kleinkuang/Imperial/Lacewing/PCB/LacewingPXE_v3p1/BOM.xlsx

Designator | Comment | Description | Manufacturer | Part No | Farnell Order Code | Mouser Order Code | Quantity
AD1 | AD8237ARMZ | Instrument Amplifier | ANALOG DEVICES | AD8237ARMZ | 2213571 |  | 1 | 10
BQ1 | BQ27750DRZT | Fuel Gauge and Protection | TEXAS INSTRUMENTS | BQ27750DRZT | 2773561 |  | 1 | 10
BQ2 | BQ25606RGET | Battery Charger | TEXAS INSTRUMENTS | BQ25606RGET | 3008740 |  | 1 | 10
C1 | 2.2uF | CAP 0402 | MURATA | GRM155R60J225ME15D | 2362088 |  | 1 | 10
C2, C3, C10, C11 | 0.1uF | CAP 0402 | AVX | 04026D104KAT2A | 1327657 |  | 4 | 40
C4, C7 | 10uF | CAP 0805 | AVX | 0805ZC106KAT2A | 2094042 |  | 2 | 20
C5 | 4.7µF | CAP 0603 | MURATA | GRM188R61C475KAAJD | 2611924 |  | 1 | 10
C6 | 10uF | CAP 0805 | MURATA | GRM21BC71E106KE11L | 2611935 |  | 1 | 10
C8 | 47nF | CAP 0402 | AVX | 0402YD473KAT2A | 2332545 |  | 1 | 10
C9 | 1uF | CAP 0805 | AVX | 08053C105JAT2A | 2332736 |  | 1 | 10
C12 | 10uF | CAP 0805 | AVX | 08056D106KAT2A | 1301818 |  | 1 | 10
C13, C17, C18, C19 | 10uF | CAP 0805 | WURTH ELEKTRONIK | 885012107010 | 2533951 |  | 4 | 40
C14, C16 | 2.2uF | CAP 0805 | MULTICOMP | MC0805B225K250CT | 2320829 |  | 2 | 20
C15 | 220uF | CAP 2917 | AVX | TAJD227K010RNJ | 197191 |  | 1 | 10
C20, C21, C22, C23, C27, C28, C29, C30 | 0.1uF | CAP 0603 | MULTICOMP | MC0603B104K500CT | 1759122 |  | 8 | 80
C24, C25 | 18pF | CAP 0603 | KEMET | C0603C180K5RACTU | 2821151 |  | 2 | 20
C26 | 4.7uF | CAP 0603 | AVX | 06036D475KAT2A | 1833803 |  | 1 | 10
C31 | 1uF | CAP 0603 | AVX | 06033D105KAT2A | 1658868 |  | 1 | 10
C32 | 10nF | CAP 0603 | KEMET | C0603C103K5RAC7081 | 2522596 |  | 1 | 10
CONNECT, D1, STAT | Green | LED SMD 0603 | KINGBRIGHT | KPT-1608SGC | 2099223 |  | 3 | 30
CSD1, CSD2 | CSD17575Q3 | MOSFET | TEXAS INSTRUMENTS | CSD17575Q3T | 3009654 |  | 2 | 20
D2, LOW, STATE | Red | LED SMD 0603 | KINGBRIGHT | KPT-1608SECK-J3 | 2335810 |  | 3 | 30
DS1 | ds7505u+ | Digital Thermometer | MAXIM | DS7505U+ | 2519297 |  | 1 | 10
J1 |  | Battery Connector | JST | S2B-PH-SM4-TB(LF)(SN) | 9492615 |  | 1 | 10
L1 | 1uH | Inductor | MURATA | DFE252012F-1R0M=P2 | 2871454 |  | 1 | 10
L2 | 15uH | Power Inductor | WURTH ELEKTRONIK | 7447714150 | 2082678 |  | 1 | 10
LM1 | LM2776DBVT | Voltage Inverter -5V | TEXAS INSTRUMENTS | LM2776DBVT | 2498456 |  | 1 | 10
LM2 | LM1086CS-3.3/NOPB | 1.5A 3.3V LDO | TEXAS INSTRUMENTS | LM1086CS-3.3/NOPB | 3121994 |  | 1 | 10
PG | Yellow | LED SMD 0603 | KINGBRIGHT | KPT-1608SYCK-J3 | 2335795 |  | 1 | 10
R1 | 0.001 | RES 1206 | VISHAY | WSLP12061L000FEA | 2420760 |  | 1 | 10
R2 | 165 | RES 0402 | VISHAY | CRCW0402165RFKED | 1150910 |  | 1 | 10
R3, R7 | 10K | Thermistor RES 0402 | PANASONIC | ERTJ0EG103FA | 1892596 |  | 2 | 20
R4 | 30.1K | RES 0402 | VISHAY | CRCW040230K1FKED | 1469704 |  | 1 | 10
R5, R6 | 100 | RES 0402 | VISHAY | CRCW0402100RFKED | 1469672 |  | 2 | 20
R8 | 5.23K | RES 0402 | VISHAY | CRCW04025K23FKED | 2140832 |  | 1 | 10
R9 | 340 | RES 0402 | PANASONIC | ERJ2RKF3400X | 2302582 |  | 1 | 10
R10, R11 | 5.1K | RES 0402 | VISHAY | CRCW04025K10FKED | 2140831 |  | 2 | 20
R12 | 10 | RES 0402 | VISHAY | CRCW040210R0FKED | 1652742 |  | 1 | 10
R13, R14 | 10M | RES 0402 | VISHAY | CRCW040210M0FKED | 1469670 |  | 2 | 20
R15, R16, R17, R42, R43, R46, R47 | 470 | RES 0402 | VISHAY | CRCW0402470RFKED | 2140742 |  | 7 | 70
R18 | 68K | RES 0402 | VISHAY | CRCW040268K0FKED | 2140918 |  | 1 | 10
R19 | 330K | RES 0402 | VISHAY | CRCW0402330KFKED | 2140980 |  | 1 | 10
R21, R22, R37, R38 | 20K | RES 0402 | VISHAY | CRCW040220K0FKED | 1469693 |  | 4 | 40
R23, R25, R30, R31, R32, R39, R40, R41, R44, R48 | 10K | RES 0402 | VISHAY | CRCW040210K0FKED | 1469669 |  | 10 | 100
R24, R26 | 1K | RES 0402 | VISHAY | CRCW04021K00FKED | 1469662 |  | 2 | 20
R27 | 24K | RES 0402 | VISHAY | CRCW040224K0FKED | 2140882 |  | 1 | 10
R28 | 30K | RES 0402 | VISHAY | CRCW040230K0FKED | 2140891 |  | 1 | 10
R29, R35, R36 | 51K | RES 0402 | VISHAY | CRCW040251K0FKED | 2140909 |  | 3 | 30
R33 | 1M | RES 0402 | VISHAY | CRCW04021M00FKED | 1469667 |  | 1 | 10
R34 | 75K | RES 0402 | VISHAY | CRCW040275K0FKED | 1469732 |  | 1 | 10
R45 | 0 | RES 0603 | MULTICOMP | MC0603SAF0000T5E | 2309111 |  | 1 | 10
RESET1 | Button |  | OMRON | B3F-1022 | 1829495 |  | 1 | 10
RN1 | RN41 | RN41 Bluetooth Module | MICROCHIP | RN41-I/RM | 2143311 |  | 1 | 10
ST_LINK/V1 | JTAG Programmer |  | AMPHENOL | T821120A1S100CEU | 2215309 |  | 1 | 10
STM1 | STM32F303RET6 | ARM Cortex-M4 32-bit MCU | STMICROELECTRONICS | STM32F303RBT6 | 2333255 |  | 1 | 10
SW1 | SPDT |  | C & K COMPONENTS | 1101M1S3ZQE2 | 1437714 |  | 1 | 10
T1 | Mini PCIe Latch | Mini PCIe Latch | MOLEX | 48099-5701 |  | 538-48099-5701 | 1 | 10
T2 | Mini PCIe connector | Mini PCIe Connector | MOLEX | 67910-5700 |  | 538-67910-5700 | 1 | 10
TCA1 | TCA0372DWG | Dual High-Power OPAMP | ON SEMICONDUCTOR | TCA0372DWG | 1468783 |  | 1 | 10
TLC1 | TLC2272AID | Dual OPAMP | TEXAS INSTRUMENTS | TLC2272AID | 3005164 |  | 1 | 10
TLC2 | TLC2274IDR | Quad OPAMP | TEXAS INSTRUMENTS | TLC2274IDR | 3117878 |  | 1 | 10
TPS1 | TPS61032PWPR | Voltage Boost +5V | TEXAS INSTRUMENTS | TPS61032PWPR | 1207333 |  | 1 | 10
USB1 | Micro-USB | ZX62R-B-5P | HIROSE | ZX62R-B-5P(30) | 2554983 |  | 1 | 10
X1 | 8MHz | Crystal Oscillator | QANTEK | QCL8.00000F18B23B | 2508448 |  | 1 | 10
P1 |  | Header, 2-Pin |  |  |  |  | 1
P2 |  | Header, 10-Pin |  |  |  |  | 1
UART1 | BL_UART | Header, 2-Pin |  |  |  |  | 1
UART2 | PC_UART | Header, 2-Pin |  |  |  |  | 1
