kleinkuang/Imperial/Lacewing/PCB/LacewingPXE_v3p1/Schematic Prints.pdf

1 1 | 2 | 2 3 3 | 4 | 4 5 5 | 6 | 6 7 7 | 8 | 8 9 9 | 10 | 10 11 11 | 12 | 12 13 13 | 14 | 14 15 15 | 16 | 16 17 17 | 18 | 18 19 19 | 20 | 20 21 21 | 22 | 22 23 23 | 24 | 24 25 25 | 26 | 26 27 27 | 28 | 28 29 29 | 30 | 30 31 31 | 32 | 32 33 33 | 34 | 34 35 35 | 36 | 36 37 37 | 38 | 38 39 39 | 40 | 40 41 41 | 42 | 42 43 43 | 44 | 44 45 45 | 46 | 46 47 47 | 48 | 48 49 49 | 50 | 50 51 51 | 52 | 52
PC9 40 | PC8 39 | PC7 38 | PC6 37 | PC5 25 | PC4 24 | PC3 11 | PC2 10

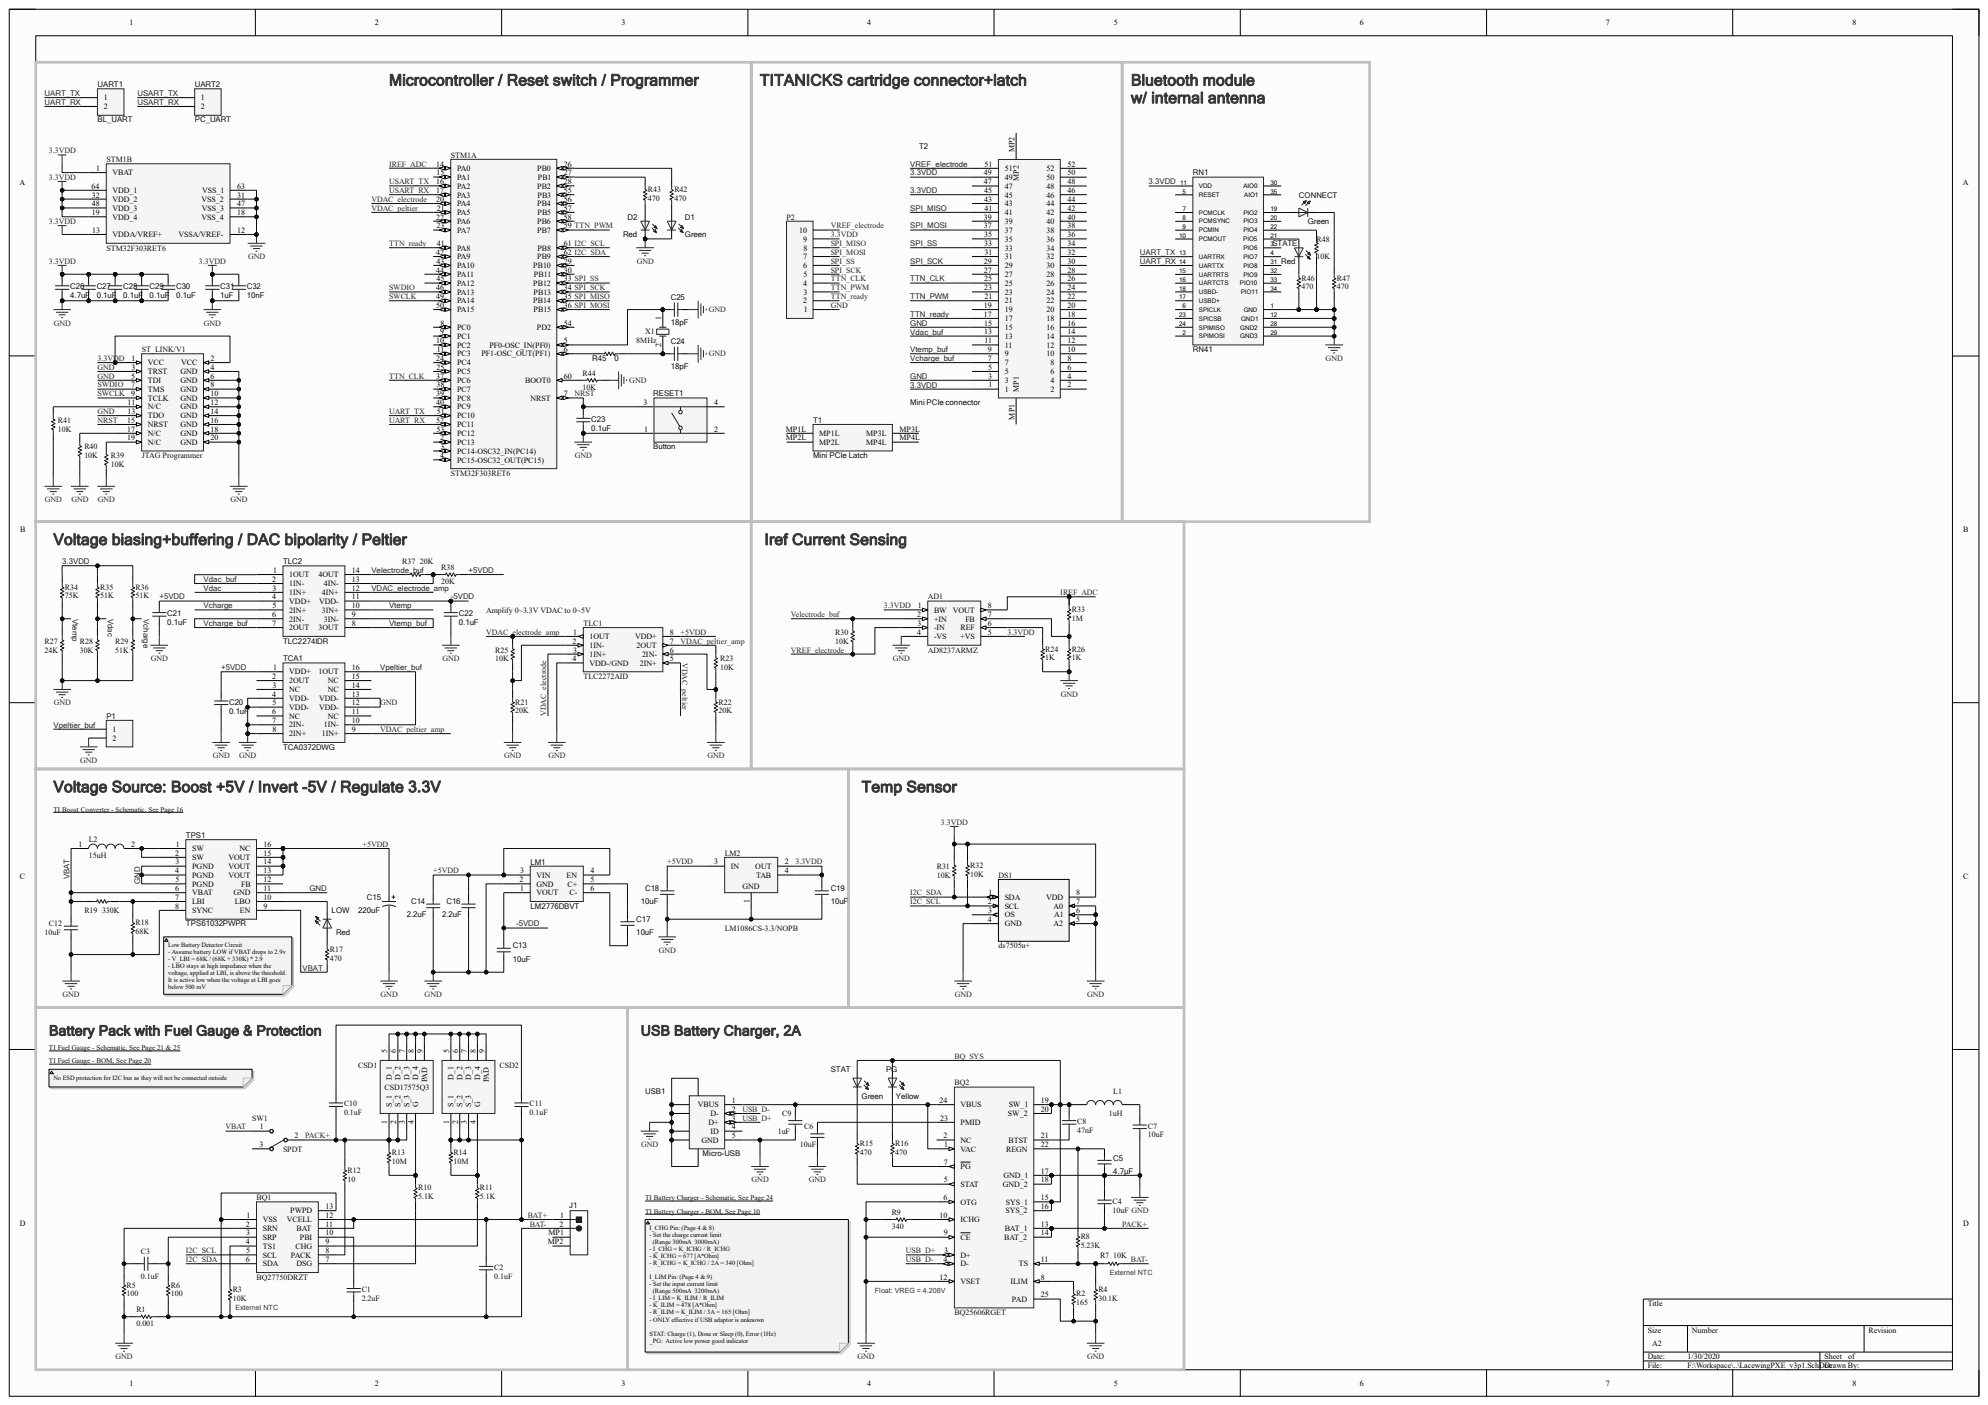
[picture p1: page 1]

Voltage biasing+buffering / DAC bipolarity / Peltier

GND
Voltage Source: Boost +5V / Invert -5V / Regulate 3.3V

TI Boost Converter - Schematic, See Page 16

Low Battery Detector Circuit
- Assume battery LOW if VBAT drops to 2.9v
- V_LBI = 68K / (68K + 330K) * 2.9
- LBO stays at high impedance when the
voltage, applied at LBI, is above the threshold.
It is active low when the voltage at LBI goes
below 500 mV

Battery Pack with Fuel Gauge & Protection

TI Fuel Gauge - Schematic, See Page 21 & 25
TI Fuel Gauge - BOM, See Page 20

No ESD protection for I2C bus as they will not be connected outside

TI Battery Charger - Schematic, See Page 24
TI Battery Charger - BOM, See Page 10

I_LIM Pin: (Page 4 & 9)
- Set the input current limit
(Range 500mA 3200mA)
- I_LIM = K_ILIM / R_ILIM
- K_ILIM = 478 [A*Ohm]
- R_ILIM = K_ILIM / 3A = 165 [Ohm]
- ONLY effective if USB adaptor is unknown

STAT: Charge (1), Done or Sleep (0), Error (1Hz)
_PG: Active low power good indicator

Size A2 | Number | Revision

Date: 1/30/2020 | Sheet of
File: F:\Workspace\..\LacewingPXE_v3p1.SchDocDrawn By:
