kleinkuang/Imperial/Lacewing/PCB/LacewingPXE_v3p1/Composite Drawing.pdf

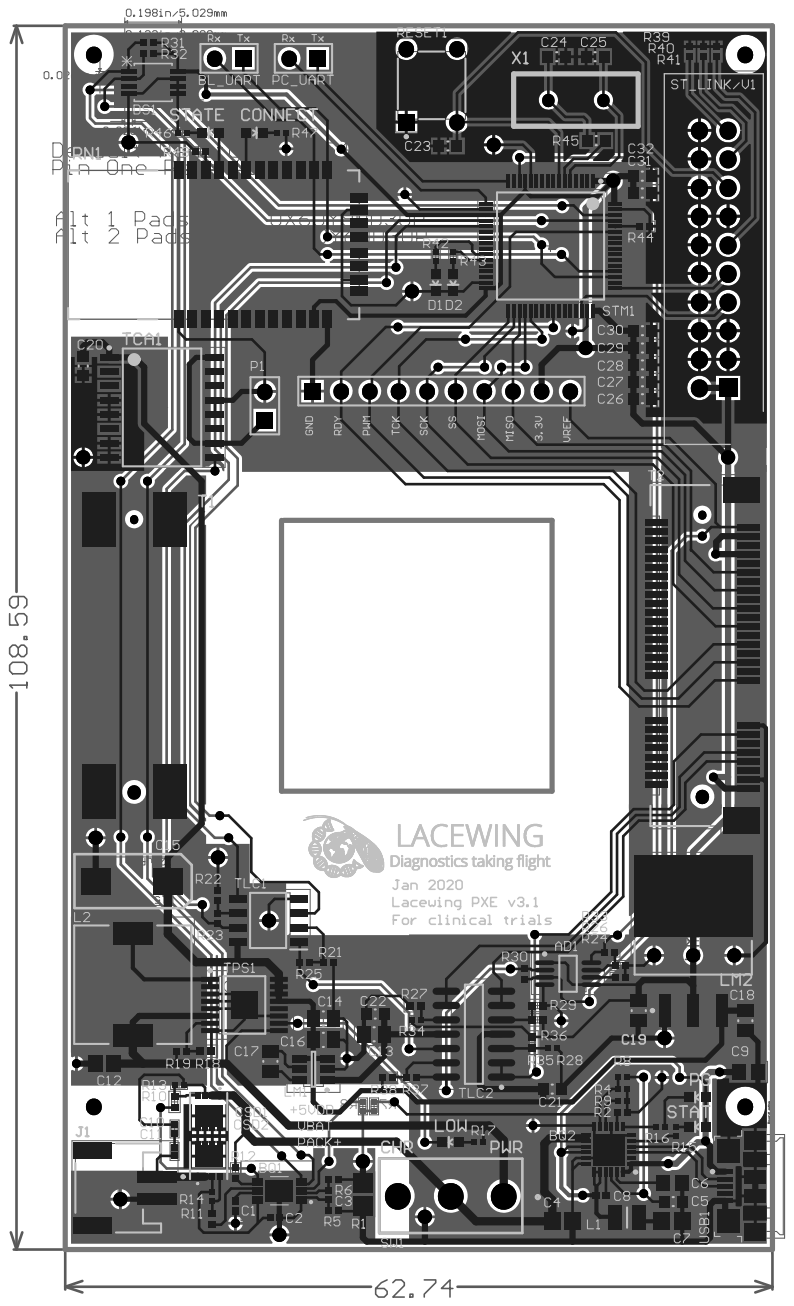
[picture p2: page 1]
