kleinkuang/Imperial/(list of files, drawings)

Other design files:
Lacewing/PCB/LacewingPXE_v3p1/LacewingPXE_v3p1.PcbDoc
Lacewing/PCB/LacewingPXE_v3p1/LacewingPXE_v3p1.PcbLib
Lacewing/PCB/LacewingPXE_v3p1/LacewingPXE_v3p1.PrjPcb
Lacewing/PCB/LacewingPXE_v3p1/LacewingPXE_v3p1.SchDoc
Lacewing/PCB/LacewingPXE_v3p1/LacewingPXE_v3p1.SchLib
