kleinkuang/Imperial/Lacewing/Firmware/L_rcc.h

// File:    L_rcc.h
// Author:  Lei Kuang
// Date:    2019.11.11
// @ Imperial College London

// System Clock Configuration

/* Includes ------------------------------------------------------------------*/
#include "stm32f3xx_hal.h"

/* Exported functions prototypes ---------------------------------------------*/
HAL_StatusTypeDef L_SystemClock_Init(void);
